Aakashpandey-01/flanged-pipe-elbow-design/cad/id0.6.SLDPRT

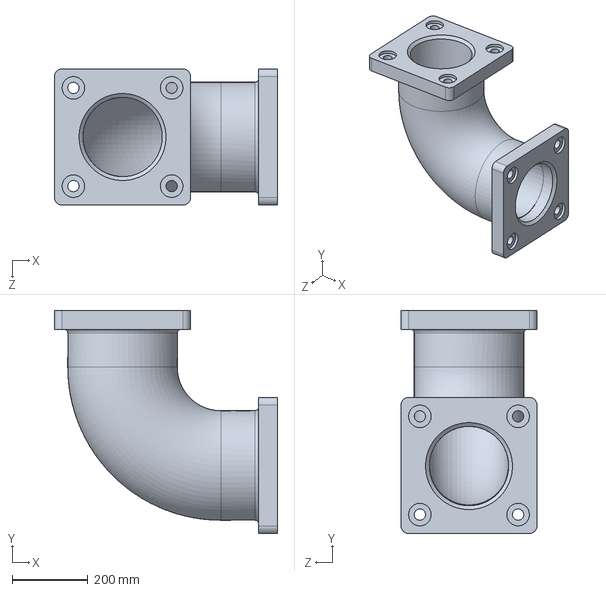
[picture p8: CAD file, 2026-10-29]
cad/id0.6.SLDPRT
590.0 x 590.0 x 360.0 mm
