Aakashpandey-01/flanged-pipe-elbow-design/drawings/flanged_elbow_drawing_A3.pdf

## TOLERANCE & GD&T SUMMARY

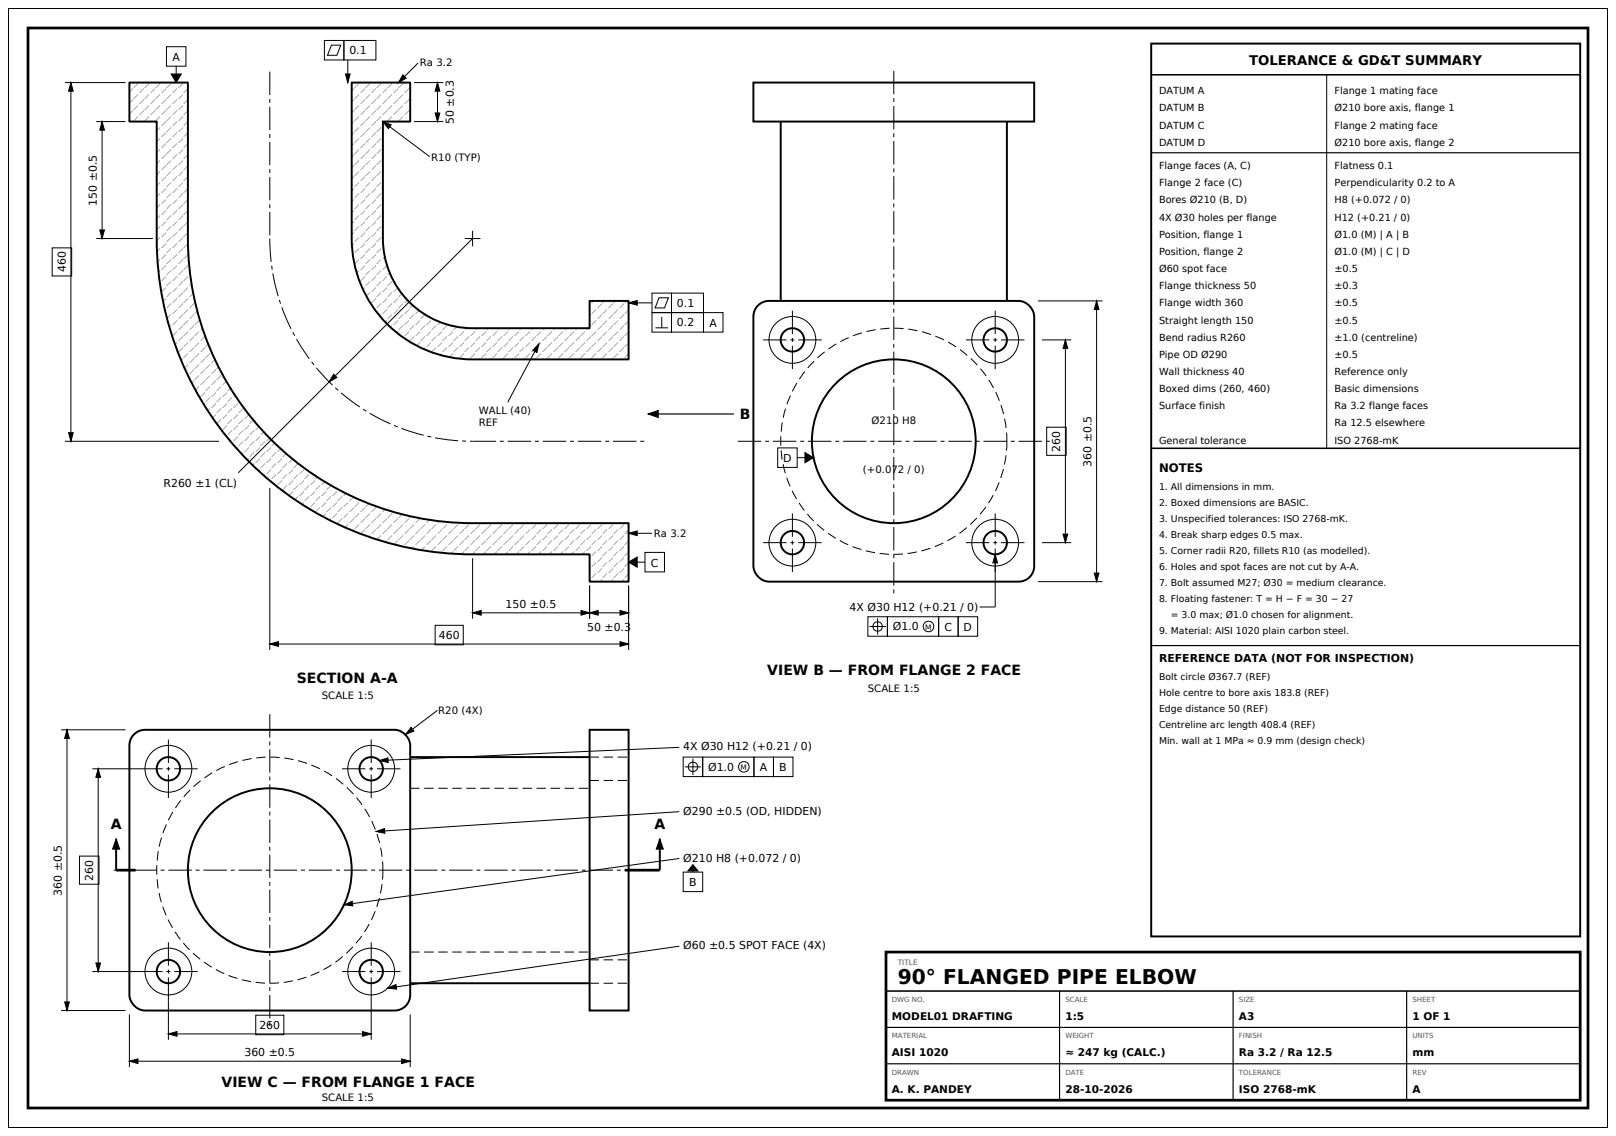
[picture p9: page 1]
WALL (40) REF; R10 (TYP); SECTION A-A; SCALE 1:5; Ø290 ±0.5 (OD, HIDDEN); Ø60 ±0.5 SPOT FACE (4X); DATUM A; Flange 1 mating face; DATUM B; Ø210 bore axis, flange 1; DATUM C; Flange 2 mating face; DATUM D; Ø210 bore axis, flange 2; Flange faces (A, C); Flatness 0.1; Flange 2 face (C); Perpendicularity 0.2 to A; Bores Ø210 (B, D); 4X Ø30 holes per flange; Position, flange 1; Position, flange 2; Ø60 spot face; Flange thickness 50; Flange width 360; Straight length 150; Bend radius R260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

NOTES
1. All dimensions in mm.
2. Boxed dimensions are BASIC.
3. Unspecified tolerances: ISO 2768-mK.
4. Break sharp edges 0.5 max.
5. Corner radii R20, fillets R10 (as modelled).
6. Holes and spot faces are not cut by A-A.
7. Bolt assumed M27; Ø30 = medium clearance.
8. Floating fastener: T = H − F = 30 − 27
= 3.0 max; Ø1.0 chosen for alignment.
9. Material: AISI 1020 plain carbon steel.

REFERENCE DATA (NOT FOR INSPECTION)
Bolt circle Ø367.7 (REF)
Hole centre to bore axis 183.8 (REF)
Edge distance 50 (REF)
Centreline arc length 408.4 (REF)
Min. wall at 1 MPa ≈ 0.9 mm (design check)

VIEW B — FROM FLANGE 2 FACE

TITLE
90° FLANGED PIPE ELBOW

VIEW C — FROM FLANGE 1 FACE
